virtualagc/agc_hardware/(threads)

Thread 1 (2021-01-28):

[question] INKBT1 dependency on STD2

emgre, 2021-01-28:
Hi, this more of a question than an issue.

I've been working on a control-pulse accurate emulator (available [here](https://github.com/emgre/agc)), and I ran into an issue when executing extended instructions. I couldn't understand the output of the Verilog simulation (generated from these schematics), where `INKBT1` was sometimes not high on `T01` even if `INKL` was always low (therefore not resetting the `NISQL` flip-flop).

`INKBT1` is defined in module A03, in the first sheet.

The schematics of ND-1021042 is the following:
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

Eldon C. Hall schematics also show the same thing:
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

However, in your KiCAD files here, you've added `STD2` to the gate:
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

Here's an example to show how `STD2` is important (notice how `NISQL` stays high when executing the extended instruction):
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

Your modification actually resolves my issue, so it's probably right. However, I wonder where you've picked this up? Are there more up-to-date schematics available somewhere, or you found that by simulation?

thewonderidiot, 2021-01-28:
Hey, that's awesome, I'll have to check it out!

STD2 gets added onto the INKBT1 net via a standalone gate in [module A21](http://klabs.org/history/ech/agc_schematics/logic/a21-2.jpg):
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

Given its location in the design, I'm guessing it was most likely a late addition to the logic that had to be added to a spare gate because the third input to gate 30061 wasn't routed out to a backplane pin.

Back when I made these schematics I was trying to go for a minimum-part replica, so I combined all of the fan-in expander gates with their parent gates wherever possible... thus its turning into a single 3-input gate in my schematics.

For instances like this, if you think there might be additional inputs to a net, it might help to use the [backplane viewer](http://apolloguidance.computer/2003993_061/pins) to search for them. If you click on the name of the "Net" on the right side toolbox, you can type in the name of a net ("INKBT1") in this case and hit enter, and it will highlight all connections to that net. That's how I dug up the above gate just now. :smile:

Hope this helps!

thewonderidiot, 2021-01-28:
I did a bit more reading and can confirm that gate 32257 in module A21 was allocated for this purpose between [revision D](https://archive.org/stream/apertureCardBox459NARASW_images/apertureCardBox459NARASW#page/n1709/mode/1up) and [revision E](https://archive.org/stream/apertureCardBox459NARASW_images/apertureCardBox459NARASW#page/n1712/mode/1up) of drawing 2005050, the schematic for the earlier nickel-ribbon version of module A21.

It's hard to read the dates, but it appears that revision E occurred in late August or September of 1965. The design release for Block II was in July of that year, so at that point it definitely would have been desirable to fix design issues with a couple of extra wires on the backplane rather than a respin of module A03, wherever possible.

emgre, 2021-01-28:
Thanks for your answer! That gate was well hidden 🥸 I wasn't aware of that backplane viewer, that's awesome!

I'm using your Verilog simulation to output a CSV of all the register values at each timepulse, then I run my Rust emulator and check that every register agrees with the CSV values. I can execute the first 100 subinstructions of Aurora12 like that. Here's the test code: https://github.com/emgre/agc/blob/master/agc/tests/conformance.rs

Closed 2021-01-28.
