virtualagc/agc_hardware/dsky/indicator_driver/indicator_driver.kicad_pcb

## KiCad design dsky/indicator_driver/indicator_driver.kicad_pcb (2017-06-05)

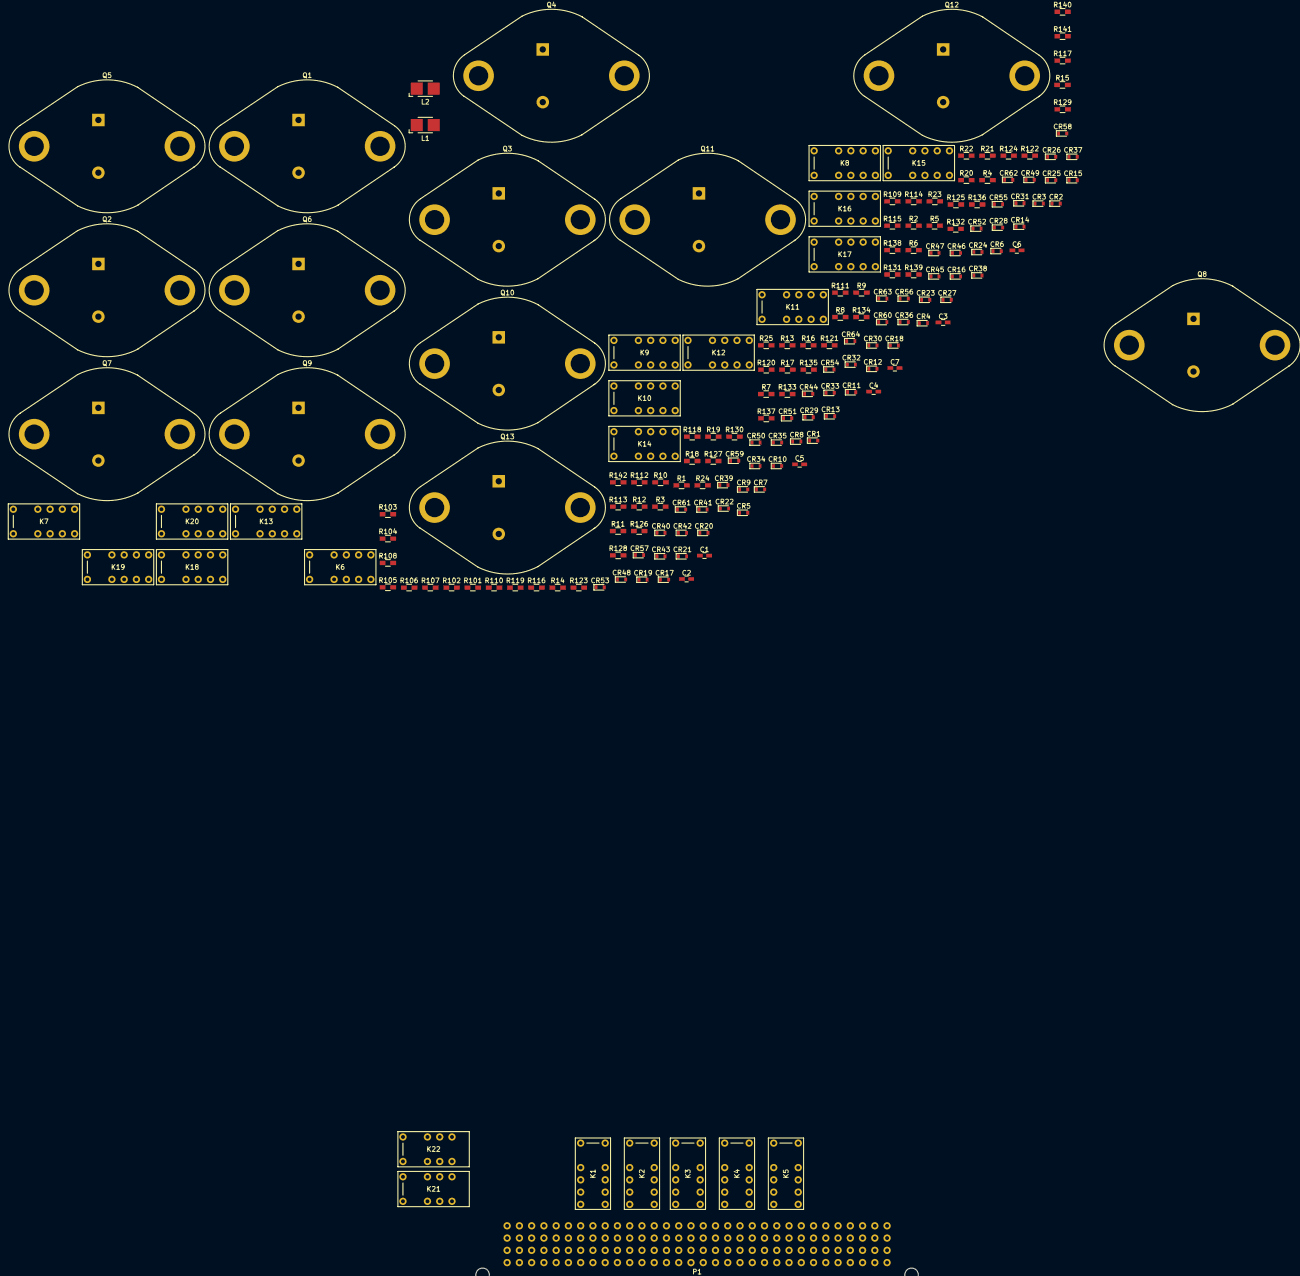
[picture p1: board indicator_driver.kicad_pcb from above]

Board: 2 copper layers, 176 parts (0 on the bottom side), 221 nets, no tracks yet.

Parts:
C1, C2: 4.7uF; C_0603_HandSoldering
C3, C4, C5, C6, C7: 0.1uF; C_0603_HandSoldering
CR1, CR2, CR3, CR4, CR5, CR6, CR7, CR8, CR9, CR10, CR11, CR12, CR13, CR14, CR15, CR16, CR17, CR18, CR19, CR20, CR21, CR22, CR23, CR24, CR25, CR26, CR27, CR28, CR29, CR30, CR31, CR32, CR33, CR34, CR35, CR36, CR37, CR38, CR39, CR40, CR41, CR42, CR43, CR44, CR45, CR46, CR47, CR48, CR49, CR50, CR51, CR52, CR53, CR54, CR55, CR56, CR57, CR58, CR59, CR60, CR61, CR62, CR63, CR64: D; D_0603
K1, K2, K3, K4, K5, K6, K7, K8, K9, K10, K11, K12, K13, K14, K15, K16, K17, K18, K19, K20: EC2-12TNU
K21, K22: EC2-12NU
L1, L2: 8.2uH; Inductor_1212
P1: PCN10A-128P
Q1, Q8, Q9, Q10, Q11, Q12, Q13: PN2907A; TO-3
Q2, Q3, Q4, Q5, Q6, Q7: PN2222A; TO-3
R1, R2, R3, R4, R6, R7, R9, R11, R12, R15, R16, R19, R22, R24: 10k; R_0603_HandSoldering
R5, R8, R10: 18k; R_0603_HandSoldering
R13, R17: 20k; R_0603_HandSoldering
R14, R18, R21, R23: 2k; R_0603_HandSoldering
R20, R25: 1k; R_0603_HandSoldering
R101, R102, R103, R104, R105, R106, R107, R108, R109, R110, R111, R112, R113, R114, R115, R116, R117, R118, R119, R120, R121, R122, R123, R124, R125, R126, R127, R128, R129, R130, R131, R132, R133, R134, R135, R136, R137, R138, R139, R140, R141, R142: 1.5k; R_0603_HandSoldering

Connections:
+28VDC: L1.1, P1.112
GND: C1.2, C2.2, CR47.2, CR48.2, CR49.2, CR50.2, P1.68, P1.105, Q2.1, Q3.1, Q5.1, Q7.1, R4.2, R7.2, R9.2, R11.2, R20.2, R25.2
unnamed: C1.1, L1.2, L2.1
unnamed: C2.1, C3.1, C4.1, C5.1, C6.1, C7.1, CR43.1, CR45.1, L2.2, Q1.1, Q8.1, Q9.1, Q10.1, Q11.1, Q12.1, Q13.1, R2.1, R3.1, R14.1, R15.1, R18.1, R19.1, R21.1, R23.1
unnamed: C3.2, Q1.2, R1.1, R2.2
unnamed: C4.2, Q8.2, R12.1, R14.2
unnamed: C5.2, Q10.2, R16.1, R18.2
unnamed: C6.2, Q12.2, R21.2, R22.1
unnamed: C7.2, Q13.2, R23.2, R24.1
unnamed: CR1.2, K1.12
unnamed: CR2.2, K1.7
unnamed: CR3.2, K2.12
unnamed: CR4.2, K2.7
unnamed: CR5.2, K3.12
unnamed: CR6.2, K3.7
unnamed: CR7.2, K4.12
unnamed: CR8.2, K4.7
unnamed: CR9.2, K5.12
unnamed: CR10.2, K5.7
unnamed: CR11.2, K6.12
unnamed: CR12.2, K6.7
unnamed: CR13.2, K7.12
unnamed: CR14.2, K7.7
unnamed: CR15.2, K8.12
unnamed: CR16.2, K8.7
unnamed: CR17.2, K9.12
unnamed: CR18.2, K9.7
unnamed: CR19.2, K10.12
unnamed: CR20.2, K10.7
unnamed: CR21.2, K11.12
unnamed: CR22.2, K11.7
unnamed: CR23.2, K12.12
unnamed: CR24.2, K12.7
unnamed: CR25.2, K13.12
unnamed: CR26.2, K13.7
unnamed: CR27.2, K14.12
unnamed: CR28.2, K14.7
unnamed: CR29.2, K15.12
unnamed: CR30.2, K15.7
unnamed: CR31.2, K16.12
unnamed: CR32.2, K16.7
unnamed: CR33.2, K17.12
unnamed: CR34.2, K17.7
unnamed: CR35.2, K18.12
unnamed: CR36.2, K18.7
unnamed: CR37.2, K19.12
unnamed: CR38.2, K19.7
unnamed: CR39.2, K20.12
unnamed: CR40.2, K20.7
unnamed: CR44.1, Q4.2, R9.1
unnamed: CR46.1, Q6.2, R11.1
unnamed: CR59.1, CR60.1, CR61.1, CR62.1, CR63.1, CR64.1, Q3.3
unnamed: K1.1, R101.1
unnamed: K1.6, R102.2
unnamed: K2.1, R103.1
unnamed: K2.6, R104.2
unnamed: K3.1, R105.1
unnamed: K3.4, K5.3
unnamed: K3.6, R106.2
unnamed: K4.1, R107.1
unnamed: K4.6, R108.2
unnamed: K5.1, R109.1
unnamed: K5.6, R110.2
unnamed: K6.1, R111.1
unnamed: K6.6, R112.2
unnamed: K7.1, R113.1
unnamed: K7.6, R114.2
unnamed: K8.1, R115.1
unnamed: K8.6, R116.2
unnamed: K9.1, R117.1
unnamed: K9.6, R118.2
unnamed: K10.1, R119.1
unnamed: K8.4, K10.3
unnamed: K10.6, R120.2
unnamed: K11.1, R121.1
unnamed: K11.6, R122.2
unnamed: K12.1, R123.1
unnamed: K12.6, R124.2
unnamed: K13.1, R125.1
unnamed: K13.4, K15.3
unnamed: K13.6, R126.2
unnamed: K14.1, R127.1
unnamed: K14.6, R128.2
unnamed: K15.1, R129.1
unnamed: K15.6, R130.2
unnamed: K16.1, R131.1
unnamed: K16.6, R132.2
unnamed: K17.1, R133.1
unnamed: K17.6, R134.2
unnamed: K18.1, R135.1
unnamed: K18.6, R136.2
unnamed: K19.1, R137.1
unnamed: K19.6, R138.2
unnamed: K20.1, R139.1
unnamed: K20.6, R140.2
unnamed: K21.12, R141.2
unnamed: K22.12, R142.2
unnamed: Q3.2, R6.1, R7.1
unnamed: Q4.1, Q5.2, R25.1
unnamed: Q6.1, Q7.2, R20.1
unnamed: Q9.2, R13.1, R15.2
unnamed: Q11.2, R17.1, R19.2
P1: K21.5, P1.1
P2: K21.10, P1.2
P3: K22.5, P1.3
P4: CR42.1, K22.1, P1.4
P5: K22.3, P1.5
P6: K22.4, P1.6
P7: CR41.1, K21.1, P1.7
P8: K21.9, P1.8
P9: K16.10, K17.10, P1.9
P10: K21.8, P1.10
P11: K21.4, P1.11
P12: K21.3, P1.12
P13: K11.10, K12.10, K13.3, K13.10, K14.10, K15.10, K19.10, K20.3, K20.10, P1.13
P14: P1.14, R102.1, R112.1, R122.1
P15: K16.5, P1.15
P16: K1.10, K2.10, K3.3, K3.10, K4.10, K5.10, K6.10, K7.10, K8.3, K8.10, K9.10, K10.10, P1.16
P17: K11.9, P1.17
P18: K16.9, P1.18
P19: P1.19, R132.1
P20: K16.3, P1.20
P21: K16.4, P1.21
P22: K1.9, P1.22
P23: P1.23, R101.2, R111.2, R121.2
P24: K6.9, P1.24
P25: K17.5, P1.25
P26: CR41.2, CR42.2, P1.26, R141.1, R142.1
P27: K16.8, P1.27
P28: P1.28, R131.2
P29: K12.5, K15.9, P1.29
P30: K2.5, K5.9, P1.30
P31: K17.3, P1.31
P32: K1.8, K2.3, K3.8, K4.8, K5.5, K5.8, K6.8, K7.3, K8.8, K9.8, K10.5, K10.8, K11.8, K12.3, K13.8, K14.8, K15.5, K15.8, K19.5, K19.8, K20.8, P1.32
P33: P1.33, R134.1
P34: K12.9, P1.34
P35: P1.35, R104.1, R114.1, R124.1
P36: K7.5, K10.9, P1.36
P37: K17.4, P1.37
P38: K17.9, P1.38
P39: K2.9, P1.39
P40: K7.9, P1.40
P41: K2.4, P1.41
P42: K7.4, P1.42
P43: K12.4, P1.43
P44: P1.44, R103.2, R113.2, R123.2
P45: K18.3, P1.45
P46: K18.5, P1.46
P47: CR31.1, CR32.1, CR33.1, CR34.1, CR35.1, CR36.1, P1.47
P48: P1.48, R133.2
P49: K8.5, K9.9, P1.49
P50: K13.5, K14.9, P1.50
P51: P1.51, R106.1, R116.1, R126.1
P52: P1.52, R136.1
P53: K12.8, K13.9, P1.53
P54: K7.8, K8.9, P1.54
P55: K2.8, K3.9, P1.55
P56: K3.5, K4.9, P1.56
P57: K17.8, K18.8, P1.57
P58: K18.4, P1.58
P59: P1.59, R135.2
P60: K18.9, P1.60
P61: P1.61, R108.1, R118.1, R128.1
P62: P1.62, R105.2, R115.2, R125.2
P63: K19.3, P1.63
P64: K18.10, P1.64
P65: P1.65, R107.2, R117.2, R127.2
P66: CR11.1, CR12.1, CR13.1, CR14.1, CR15.1, CR16.1, CR17.1, CR18.1, CR19.1, CR20.1, P1.66
P67: CR21.1, CR22.1, CR23.1, CR24.1, CR25.1, CR26.1, CR27.1, CR28.1, CR29.1, CR30.1, P1.67
P69: CR37.1, CR38.1, P1.69
P70: K19.9, P1.70
P71: CR1.1, CR2.1, CR3.1, CR4.1, CR5.1, CR6.1, CR7.1, CR8.1, CR9.1, CR10.1, P1.71
P72: P1.72, R138.1
P73: P1.73, R110.1, R120.1, R130.1
P74: K20.5, P1.74
P75: P1.75, R137.2
P76: K19.4, P1.76
P77: P1.77, R109.2, R119.2, R129.2
P78: K15.4, P1.78
P79: K20.9, P1.79
P80: P1.80, R140.1
P81: P1.81, R139.2
P82: K20.4, P1.82
P83: K5.4, P1.83
P84: K10.4, P1.84
P85: P1.85, R22.2
P86: P1.86, R24.2
P87: P1.87, Q12.3
P88: CR39.1, CR40.1, P1.88
P89: P1.89, R16.2
P90: P1.90, R12.2
P91: P1.91, R1.2
P92: P1.92, Q1.3
P94: CR57.2, P1.94
P95: P1.95, Q13.3
P97: CR53.2, P1.97
P98: CR54.2, P1.98
P99: CR55.2, P1.99
P100: CR56.2, P1.100
P101: CR49.1, P1.101, Q11.3
P102: CR47.1, P1.102, Q9.3
P103: CR50.1, P1.103, Q10.3, R17.2
P104: CR48.1, P1.104, Q8.3, R13.2
P106: CR46.2, P1.106, R10.2
P107: CR44.2, R8.2
P108: CR52.2, P1.108
P109: CR60.2, P1.109
P110: CR51.2, P1.110
P111: CR51.1, CR52.1, CR53.1, CR54.1, CR55.1, CR56.1, CR57.1, P1.111, Q2.3, R3.2, R6.2
P113: CR45.2, P1.113, Q6.3, Q7.3
P114: CR43.2, P1.114, Q4.3, Q5.3
P115: P1.115, R5.2
P116: CR59.2, P1.116
P117: CR62.2, P1.117
P118: CR61.2, P1.118
P119: P1.119, Q2.2, R4.1, R5.1
P120: P1.120, R8.1, R10.1
P121: CR58.1, P1.121
P122: CR64.2, P1.122
P123: CR58.2, P1.123
P124: CR63.2, P1.124
