virtualagc/agc_hardware/(commit log)

2015-10-11 Initial schematicery
    [timer.kicad_pcb, timer.sch]
2015-10-11 More of page 1 of the timer module (poorly drawn)
    [timer.sch]
2015-10-13 Fleshed out the rest of page 1 of the timer module
    [timer.sch]
2015-10-13 Added PHS3/ from A24-2 since it makes more sense in the timer modules, along with the two monitor signals on A2-1, and an inverter and signal I missed
    [timer.sch]
2015-10-18 Pushed page A02-1 down into a heirarchical sheet, while retaining the P1 connector at the top level. Also added the beginnings of page A02-2. The four-phase clock divider is now also on its own page,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
    [a02_1.sch, a02_2.sch, clock_divider.sch, timer.sch]
2015-10-20 Added the start/stop logic to timer page A02-2, and introduced a new part, 74LVC07, that I think will be the solution for open drain things
    [a02_2.sch, clock_divider.sch, timer.sch]
2015-10-24 Added the final page of the timer module. Leaving top-level wiring pretty bare for now until I have a better idea of what's needed outside the module.
    [a02_1.sch, a02_2.sch, a02_3.sch, clock_divider.sch, timer.sch]
2015-10-24 Added the entire scaler module! Didn't flesh out the I/O much, I'll do that as needed. Also, the clock divider's labeling here is different from the one in the timer module, which is consistent with 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
    [a01_1.sch, a01_2.sch, clock_divider.sch, scaler.kicad_pcb, scaler.sch, timer.sch]
2015-10-25 Beginnings of the SQ Register and Decoding module -- mostly SQ read/write/clear logic
    [a03_1.sch, sq_register.kicad_pcb, sq_register.sch]
2015-10-26 Filled out the rest of page A03-1. At the very least, it appears to be properly handling the GOJAM condition. Haven't looked much at non-GOJAM behavior. I also exposed T01..T12 and T01/..T12/ as outp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
    [a02_2.sch, a03_1.sch, sq_register.sch, timer.sch]
2015-10-27 Renamed components in the timer module to fit the new numbering scheme (module_number * 1000 + part number), and updated initial conditions to make simulation happy again after fixes
    [a02_1.sch, a02_2.sch, a02_3.sch, a03_1.sch, clock_divider.sch]
2015-10-29 Finished off the SQ Register and Decoder module. Next up is the stage and branch registers
    [a03_1.sch, a03_2.sch, sq_register.sch]
2015-10-29 Added the 'stage' bit of the Stage Branch Decoder module, and cleaned up a lot of initial conditions (still probably a lot to be done there)
    [a02_1.sch, a02_2.sch, a02_3.sch, a03_1.sch, a03_2.sch, a04_1.sch, sq_register.sch, stage_branch.kicad_pcb]
2015-10-29 More initial conditions fixes, prevents STG3 from oscillating and freqking out TC0
    [a03_1.sch, a03_2.sch, a04_1.sch]
2015-10-31 Finished off the first page of the Stage Branch Decoding module.
    [a04_1.sch, sq_register.sch, stage_branch.sch, timer.sch]
2015-11-01 Added the strobe pulses to the timer
    [a02_2.sch, clock_divider.sch, timer.sch]
2015-11-20 Added a library part for a 128-pin DIN 41612 connector. It's unclear if 128 pins will be enough for some modules (yikes) but I'm going to try my hardest to make it work.
2015-11-20 Added page 2 of the Stage Branch Decoding module, and tied it into the rest of the system
    [a03_1.sch, a03_2.sch, a04_1.sch, a04_2.sch, sq_register.sch, stage_branch.sch]
2015-11-26 Added the first page of the Crosspoint Generator NQI module. Not dealing with I/O until page 2 is also present...
    [a05_1.sch, crosspoint_nqi.kicad_pcb, crosspoint_nqi.sch]
2015-12-19 Finished the second page of crosspoint generator 1 and tied it into the rest of the system.
    Turns out most documentation online is wrong, and block 2 modules have 276 pins per module to the backplane, rather than the 140-144 that is quoted everywhere (those are block 1 figures). Instead of dealing with connector selection again, I opted to just add another row to the '128-pin' connector. I'll fix that more properly later
    [a03_1.sch, a03_2.sch, a05_1.sch, a05_2.sch, crosspoint_nqi.sch, sq_register.sch, stage_branch.sch]
2015-12-20 First page of module A06, crosspoint generator #2.
    There's a lot of gates I left out that produce unused (monitor?)
    signals... namely the S01..S07/ -> IL01..IL07/ mappings, and the
    RSTK/ -> RSTKX/ + RSTKY/ things. I also moved what looks like additional
    timer logic to page 2 of the timer module (it's a really good fit there
    because no new input pins are needed, all involved signals are generated
    on that page).
    [a02_2.sch, a06_1.sch, crosspoint_ii.kicad_pcb, crosspoint_ii.sch, timer.sch]
2015-12-22 Page 2 of module 6, plus a few corrections.
    Changed RPTSET in module 3 from an output to an input. Dropped unneeded
    pullups from R1C/ (turns out this missing one is in module 6) and RB1/
    (I don't remember why that was there) in module 4.
    [a03_1.sch, a04_2.sch, a06_1.sch, a06_2.sch, crosspoint_ii.sch, sq_register.sch]
2015-12-23 Tied in module 6 and corrected a handful of naming/routing errors... most notably some missing gates from A06-1
    [a04_1.sch, a04_2.sch, a05_1.sch, a05_2.sch, a06_1.sch, a06_2.sch, crosspoint_ii.sch, sq_register.sch]
2015-12-24 A few crosspoint touchups I missed
    [crosspoint_nqi.sch]
2015-12-24 Page 1 of module 7, the service gates
    [a07_1.sch, service_gates.kicad_pcb, service_gates.sch]
2015-12-29 Page 2 of the service gates, including some service logic taken from modules 14 and 24 (page 1 got some updates too)
    [a07_1.sch, a07_2.sch, service_gates.sch]
2015-12-29 Broke out some open drain signals that were only partially onto the backplane... I missed them because inouts are sufficient to satisfy an input criterion, so there's no error if only part of the sig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
    [crosspoint_ii.sch, crosspoint_nqi.sch]
2015-12-30 Tied in module 7, and corrected lots of errors.
    Off the top of my head:
    * T12DC/ not actually connected to restart logic in A02-2
    * IC12/ and IC13 schematic errors
    * Lots of gates moved from later modules up to modules 2-7
    * YT0..7 logic dropped from 7, it belongs in 14
    * Lots of missing signal breakouts
    * ...probably some other things, I should keep a list as I go
    All control pulses associated with GOJ1 now behave correctly during
    GOJ1.
    [a02_2.sch, a02_3.sch, a03_1.sch, a03_2.sch, a04_1.sch, a04_2.sch, a05_1.sch, a05_2.sch]
2016-01-03 More corrections, TC0, CA0, and STD2 all have the right pulses now
    [a06_2.sch, crosspoint_nqi.sch]
2016-01-03 Added a generic two-bit-column sheet that I'm going to try to handle with symlinks, plus a basic module 8 to contain the first instance of it
    [four_bit_1.kicad_pcb, four_bit_1.sch, two_bit_columns.sch]
2016-01-03 Added the second instance of the two-bit-columns sheet. Wiring of module 8 next
    [four_bit_1.sch, two_bit_columns.sch]
2016-01-05 Tied in module 8, and corrected lots of initial conditions.
    The registers and ALU appear to work now, with TC0 and STD2 shuffling things around correctly, and Z counting up as instructions execute.
    [a02_3.sch, a03_2.sch, a04_2.sch, a05_1.sch, a05_2.sch, a06_1.sch, a06_2.sch, a07_1.sch]
2016-01-06 Fully added / tied in module 9. Yay for identical logic!
    [four_bit_2.kicad_pcb, four_bit_2.sch, two_bit_columns.sch]
2016-01-06 Added a fully tied in module 10.
    [four_bit_2.sch, four_bit_3.kicad_pcb, four_bit_3.sch, service_gates.sch, two_bit_columns.sch]
2016-01-31 Added the final four bit module. All 16 bits of the central/special registers are present. We're stuck at address 0 because TC is using RAD, which needs to be translated into RG or RZ by module 12
    [a03_1.sch, a03_2.sch, a06_1.sch, a07_1.sch, a07_2.sch, crosspoint_ii.sch, four_bit_3.sch, four_bit_4.kicad_pcb]
2016-01-31 Added in WHOMP, whatever it is
    [a06_1.sch, crosspoint_ii.sch, four_bit_1.sch, four_bit_2.sch, four_bit_3.sch, four_bit_4.sch, two_bit_columns.sch]
2016-02-07 Added and tied in module 12, parity & s register
    [a02_3.sch, a05_2.sch, a06_1.sch, a06_2.sch, a07_1.sch, a07_2.sch, a12_1.sch, a12_2.sch]
2016-02-11 Bux fixes for things found during FPGA integration.
    * A05 was driving TSGN/ directly instead of with an OD buffer+pullup
    * Some bad logic with crosspoints in module 5
    * A bad part number in module 12
    * Removal of unused signals from the backplane connectors
    * Addition of some monitor signals from the timer to the backplane
    [a05_1.sch, a05_2.sch, a12_1.sch, crosspoint_nqi.sch, stage_branch.sch, timer.sch]
2016-02-12 Fixed oscillations of OVFSTB/ in the timer module
    [a02_1.sch, a02_2.sch, a02_3.sch, timer.sch]
2016-02-13 First bit of memory timing and addressing (fixed memory timing)
    [a14_1.sch, memory_timing_addressing.kicad_pcb, memory_timing_addressing.sch]
2016-02-17 Corrected a couple of bugs found by Quartus (L16/, Z15/, Z16/ not connected)
    [crosspoint_nqi.sch, four_bit_4.sch, stage_branch.sch]
2016-02-19 Finished off and integrated module 14. Also fixed a couple of bugs this turned up (both initial conditions, and bad wiring in the CGMC pulse generator and S register)
    [a04_2.sch, a05_2.sch, a06_1.sch, a06_2.sch, a07_1.sch, a12_2.sch, a14_1.sch, a14_2.sch]
2016-02-21 Added and tied in module 15, the rupt service (and banking/rope+strand selection)
    [a06_2.sch, a07_2.sch, a15_1.sch, a15_2.sch, crosspoint_ii.sch, crosspoint_nqi.sch, four_bit_1.sch, four_bit_2.sch]
2016-02-24 New module: custom memory! This uses a flash chip and decodes address based entirely off of rope control signals.
    [a14_1.sch, b01_1.sch, fixed_erasable_memory.kicad_pcb, fixed_erasable_memory.sch, memory_timing_addressing.sch, rupt_service.sch]
2016-02-28 Updated fixed memory model, plus various bugfixes
    Rope memory control signals are now decoded much earlier in the cycle to
    determine the target address, allowing slower memory devices (such as
    the EPCS on the DE0 Nano) enough time to load their data.
    The bugfixes are mostly wiring errors discovered by debugging lockups in
    when running Colossus 237 -- all were causing the ST2 pulse to not
    occur, so errors that *don't* prevent ST2 from happening very well might
    be present in the instructions that have been fixed.
    The computer now gets through the initialization code and enters an
    infinite loop when attempting to invoke the interpeter, due to the lack
    of erasable memory.
    [a03_2.sch, a04_2.sch, a05_1.sch, b01_1.sch, fixed_erasable_memory.sch, memory_timing_addressing.sch, rupt_service.sch]
2016-03-04 Added erasable memory, and fixed lots of random wiring errors.
    I decided to go with a 16-bit-wide MRAM chip -- I had no idea
    until I started researching RAM options how technologically
    similar MRAM is to core memory. The datasheet diagrams look like
    they're straight out of the AGC documentation!
    There's a slight inaccuracy in this implementation worth mentioning.
    Like fixed memory, I've wired the sense amplifier outputs directly up
    to the tristate data output pins of the MRAM chip. But because the
    data lines are bidirectional, data being written into RAM will show up
    on the sense lines, and go straight into the ungated G register. Since
    G is what's being written out, this doesn't matter 99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
    [a04_1.sch, a04_2.sch, a05_1.sch, a05_2.sch, a06_1.sch, a07_2.sch, a12_1.sch, a12_2.sch]
2016-03-06 Higher fidelity rope logic that doesn't break with DV.
    Divide, somewhat strangely, handles the ropes differently during its
    execution than any other instruction (at least, that I've seen). It does
    full cycles on a rope, just without strobing the sense amplifiers at the
    end. Plus, that rope is kinda random -- DV1 timepulse 8 seems to set bit
    12 of S for some reason. Anyways, I had to switch to three edge
    detectors that clear the A/B/C quarter latches with the RESETA, RESETB,
    and RESETC pulses, instead of just using SBF for everything.
    [b01_1.sch]
2016-03-06 New bidirectional codegen flags for the MRAM chip.
    [b01_2.sch]
2016-03-13 Added counter cell 1. No output pins to the backplane yet
    [a20_both.sch, counter_cell_i.kicad_pcb, counter_cell_i.sch]
2016-03-26 Added in counter cell 2.
    I moved some logic from module 5 that's related to counters into page 1,
    and completely moved page 2 out, since it has more to do with monitor
    stuff. That'll show up as page 2 of module 13.
    [a05_1.sch, a05_2.sch, a21_1.sch, a21_3.sch, counter_cell_ii.kicad_pcb, counter_cell_ii.sch, crosspoint_nqi.sch]
2016-03-26 Tied in modules 20 and 21
    [a21_1.sch, a21_3.sch, counter_cell_i.sch, counter_cell_ii.sch, crosspoint_nqi.sch, memory_timing_addressing.sch]
2016-04-01 Added and tied in the Alarms module.
    I've placed page 2 of Counter Cell 2 here as page 2 of alarms. It didn't
    fit in the counter cells, despite producing a few counter-related
    signals -- and it mostly handles monitor stuff, which is a good fit for
    what's going on here. As part of this I modernized the timer and scaler
    connectors.
    There seems to be lots of oscillations in the the simulation. Initial
    conditions to correct those to follow.
    [a01_1.sch, a02_2.sch, a02_3.sch, a13_1.sch, a13_2.sch, a21_1.sch, alarms.kicad_pcb, alarms.sch]
2016-04-02 Initial conditions for the counter cells
    [a20_both.sch, a21_3.sch]
2016-04-09 Inout IV. Not yet tied into the backplane.
    [a19_1.sch, a19_2.sch, inout_iv.kicad_pcb, inout_iv.sch]
2016-04-09 Tied in Inout IV and renamed MONPCH to the original MON+CH
    [a01_1.sch, a02_2.sch, a05_1.sch, a05_2.sch, a06_2.sch, a13_2.sch, a19_1.sch, a19_2.sch]
2016-04-09 Corrected some bad identifiers found by Quartus
    [a20_both.sch, b01_2.sch]
2016-04-10 Inout II. Not yet tied in.
    [a17_1.sch, a17_2.sch, inout_ii.kicad_pcb, inout_ii.sch]
2016-04-10 Tied in Inout II.
    [a01_1.sch, a17_1.sch, a17_2.sch, alarms.sch, inout_ii.sch, inout_iv.sch, scaler.sch, service_gates.sch]
2016-04-12 Added and tied in Inout I
    [a16_1.sch, a16_2.sch, inout_i.kicad_pcb, inout_i.sch, inout_ii.sch]
2016-04-14 First half-ish of Inout III
    [a18_1.sch, a18_2.sch, inout_iii.kicad_pcb, inout_iii.sch]
2016-04-16 Added most of the rest of Inout III and tied it in. Still not sure where to put the downlink stuff, standby, and CHOR propers.
    [a01_1.sch, a18_1.sch, a18_2.sch, inout_iii.sch, inout_iv.sch, scaler.sch, timer.sch]
2016-04-17 Added and tied in Inout V.
    [a22_1.sch, a22_2.sch, inout_v.kicad_pcb, inout_v.sch, parity_s_register.sch, rupt_service.sch]
2016-04-18 Added and tied in Inout VI. Pulled in all PIPA related things. Almost there!
    [a07_1.sch, a19_2.sch, a22_2.sch, a23_1.sch, a23_2.sch, inout_i.sch, inout_ii.sch, inout_iv.sch]
2016-04-20 Added interrupt inhibition to module 3
    [a03_1.sch, crosspoint_nqi.sch, four_bit_4.sch, sq_register.sch, two_bit_columns.sch]
2016-04-20 Fixed the two bit column simlink in four bit 4
    [two_bit_columns.sch]
2016-04-21 Added and tied in Inout VII, the final logic module!
    I still need to comb through the schematics to see if there are any
    stray gates I missed. The initial conditions are also pretty much
    guaranteed to be wrong. But it's mostly all there!
    [a04_2.sch, a06_1.sch, a24_1.sch, a24_2.sch, four_bit_1.sch, four_bit_2.sch, four_bit_3.sch, four_bit_4.sch]
2016-04-21 Corrected a couple of wiring errors in the scaler
    [a01_1.sch, a01_2.sch]
2016-04-22 Lots of initial conditions, some missed gates, and some wiring fixes
    [a03_1.sch, a06_1.sch, a07_1.sch, a13_1.sch, a14_1.sch, a16_1.sch, a18_1.sch, a18_2.sch]
2016-04-28 Did another pass through the schematics and added in some missing gates
    [a03_2.sch, a13_1.sch, a15_2.sch, a18_1.sch, alarms.sch, inout_iii.sch, sq_register.sch]
2016-04-30 Corrected some bad part identifiers
    [a03_1.sch, a23_1.sch, a24_1.sch]
2016-04-30 Broke out most (all?) of the DSKY outputs
    [a16_2.sch, alarms.sch, inout_i.sch, inout_ii.sch]
2016-05-05 Pulled out RESTRT and SBYLIT for the final two DSKY lights
    [alarms.sch, inout_iii.sch]
2016-05-05 Corrected RESTART light polarity in the alarms module
    [a13_1.sch]
2016-06-23 Added basic DSKY relay decoding and a library part for the relays
    [indicator_driver.kicad_pcb, indicator_driver.sch, seven_segment_decoder.sch]
2016-07-23 Added some missing net names.
    [a04_1.sch, a24_2.sch]
2016-07-24 Broke out some PIPA and CDU-related output signals, and fixed the polarity of PIPPLS/
    [a23_2.sch, a24_1.sch, a24_2.sch, inout_vi.sch, inout_vii.sch]
2016-09-14 Broke all the monitor outputs I could find out to the backplane, in preparation for making a monitor
    [a03_1.sch, a03_2.sch, a04_1.sch, a04_2.sch, a06_1.sch, a12_1.sch, alarms.sch, crosspoint_ii.sch]
2016-09-18 Corrected a wiring error in the Monitor request logic (ST1 in place of ST0) and an initial condition problem in the scaler causing the computer to come up with night watchman alarm
    [a13_1.sch, a13_2.sch, alarms.sch, clock_divider.sch]
2016-10-01 Made erasable memory reads destructive, and improved erasable address latching logic
    [b01_2.sch, fixed_erasable_memory.sch, memory_timing_addressing.sch]
2016-10-04 Some initial condition updates to fix a couple oscillating signals I found
    [a13_1.sch, a23_1.sch]
2016-10-05 Fixed memory: inhibit reads if no rope is selected, which can happen when addressing non-present memory
    [b01_1.sch]
2016-10-06 SUPER BROKEN: Pulled in all NOR gates into the custom library, and changed the shape of 74HC04. Some, but not all, gates have standalone power pin parts. Scaler and Timer have been updated to use the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
    [a01_1.sch, a01_2.sch, a02_1.sch, a02_2.sch, a02_3.sch, clock_divider.sch, scaler.sch, timer.sch]
2016-10-08 Not gate rewiring up through module 11, with other cleanup here and there
    [a03_1.sch, a03_2.sch, a04_1.sch, a04_2.sch, a05_1.sch, a05_2.sch, a06_1.sch, a06_2.sch]
2016-10-09 Fixed not->1-input nor in the rest of the modules.
    [a12_1.sch, a12_2.sch, a13_1.sch, a13_2.sch, a14_1.sch, a14_2.sch, a15_1.sch, a15_2.sch]
2016-10-15 Added power pin units to most parts, +4VDC and +4VSW power components, and updated Scaler to use it all.
    [a01_1.sch, a01_2.sch, clock_divider.sch, scaler.sch]
2016-10-23 Added switched and unswitched power nets to the Timer. Also fixed a few glitches in the new library parts.
    [a02_1.sch, a02_2.sch, a02_3.sch, clock_divider.sch, timer.sch]
2016-10-23 Switched SQ Register & Decoder over to +4VSW and fixed some straggling VCCs in Timer
    [a02_2.sch, a02_3.sch, a03_1.sch, a03_2.sch, sq_register.sch, timer.sch]
2016-10-23 Updated Stage Branch Decoding to be on +4VSW
    [a04_1.sch, a04_2.sch, stage_branch.sch]
2016-10-23 Updated Crosspoint NQI to be on +4VSW
    [a05_1.sch, a05_2.sch, crosspoint_nqi.sch]
2016-10-23 Updated Crosspoint II to be on +4VSW
    [a06_1.sch, a06_2.sch, crosspoint_ii.sch]
2016-10-24 Updated Service Gates to be on +4VSW
    [a07_1.sch, a07_2.sch, service_gates.sch]
2016-10-24 Updated Four Bit 1 to be on +4VSW. Also compacted chip usage somewhat.
    [four_bit_1.sch, two_bit_columns.sch]
2016-10-24 Updated Four Bit 2 to be on +4VSW. Performed the same consolidation as in 1.
    [four_bit_2.sch, two_bit_columns.sch]
2016-10-26 Updated Four Bit 3 to be on +4VSW. Performed the same consolidation as in 1+2.
    [four_bit_3.sch, two_bit_columns.sch]
2016-10-26 Updated Four Bit 4 to be on +4VSW. Performed the same consolidation as in 1+2+3.
    [four_bit_4.sch, two_bit_columns.sch]
2016-10-26 Updated Parity and S Register to be on +4VSW
    [a12_1.sch, a12_2.sch, parity_s_register.sch]
2016-10-31 Set up Alarms for +4VDC and +4VSW power nets. Pretty sure I got all the standby stuff...
    [a13_1.sch, a13_2.sch, alarms.sch]
2016-10-31 Updated Memory Timing and Addressing to be on +4VSW
    [a14_1.sch, a14_2.sch, memory_timing_addressing.sch]
2016-11-01 Updated Rupt Service to be on +4VSW
    [a15_1.sch, a15_2.sch, rupt_service.sch]
2016-11-01 Updated Inout I to be on +4VSW
    [a16_1.sch, a16_2.sch, inout_i.sch]
2016-11-01 Updated Inout II to be on +4VSW
    [a17_1.sch, a17_2.sch, inout_ii.sch]
2016-11-01 Updated Inout III for the new power nets. Conveniently, only the standby-controlling stuff is on standby power
    [a18_1.sch, a18_2.sch, inout_iii.sch]
2016-11-01 Updated Inout IV to be on +4VSW
    [a19_1.sch, a19_2.sch, inout_iv.sch]
2016-11-02 Power net updates for Counter Cell I+II and Inout V
    [a20_both.sch, a21_1.sch, a21_3.sch, a22_1.sch, a22_2.sch, counter_cell_i.sch, counter_cell_ii.sch, inout_v.sch]
2016-11-02 Updated Inout VI to be on +4VSW
    [a23_1.sch, a23_2.sch, inout_vi.sch]
2016-11-02 Updated power nets for Inout VII. Almost there...
    [a24_1.sch, a24_2.sch, inout_vii.sch]
2016-11-02 Fixed/erasable memory on switched power, and voltage pin updates for the memories and tristate buffers
    [b01_1.sch, b01_2.sch, fixed_erasable_memory.sch]
2016-11-02 Pulled TIMR generation off of standby power, and consolidated some parts
    [a02_2.sch, a02_3.sch, a03_1.sch, a03_2.sch, a04_1.sch, a04_2.sch, a05_1.sch, a05_2.sch]
2016-11-02 Initial conditions for flash read logic
    [b01_1.sch]
2016-11-02 Some designator fixes for four bit 4, which apparently halfway thought it was module 10
    [four_bit_4.sch, two_bit_columns.sch]
2016-11-02 Broke out SBYREL/ for +4VSW switching
    [a18_1.sch, a18_2.sch, inout_iii.sch]
2016-11-05 New (original) seven-segment decoder, taken from the Apollo 12 Mission Report
    [indicator_driver.sch, seven_segment_decoder.sch]
2016-11-06 Added in the rest of the IDM hardware. Values and diode matrix design still need to be finalized. Working on wiring everything up now.
    [indicator_driver.sch, line_driver.sch, nonlatching_relay.sch, relay_driver.sch, seven_segment_decoder.sch]
2016-11-06 Finished initial wiring of the Indicator Driver Module. Currently sitting at 111 pins used, so I've been too aggressive at culling pins
    [indicator_driver.sch, line_driver.sch, seven_segment_decoder.sch]
2016-11-06 DSKY IDM: Cleaned up design rule errors. Still don't fully understand the common returh path.
    [indicator_driver.sch, line_driver.sch, nonlatching_relay.sch, relay_driver.sch, seven_segment_decoder.sch]
2016-11-06 Added a preliminary digital indicator board. Currently planning on custom 7SDs.
    [7SD.sch, digital_indicator.kicad_pcb, digital_indicator.sch, sign.sch]
2016-11-06 Basic alarm indicator module
    [alarm_indicator.kicad_pcb, alarm_indicator.sch]
2016-11-06 Added a DSKY keyboard board, which should be it for the DSKY outside of the backplane. Currently assuming I'll be making my own keys
    [keyboard.kicad_pcb, keyboard.sch]
2016-11-07 Upon re-reading R-700, the DSKY buttons were SPDT, not 1NO1NC. The keyboard has been updated accordingly.
    [keyboard.sch]
2016-11-07 The AGC only generates KEYRUPTs when it gets a non-zero keycode, so PRO can safely be on the keyboard reset chain.
    [keyboard.sch]
2016-11-07 The LM System Handbook, however, shows that PRO is *not* on the reset chain...
    Revert "The AGC only generates KEYRUPTs when it gets a non-zero keycode, so PRO can safely be on the keyboard reset chain."
    This reverts commit 773c8305ed61eff056e970f90c0f0f145b3fc18d.
    [keyboard.sch]
2016-11-07 Reordered all the keys in the DSKY keyboard to give them the same 'priority' as the original.
    [keyboard.sch]
2016-11-23 Fixed a label that became disconnected in module 6, causing DV to sometimes go off the rails
    [a06_1.sch, a06_2.sch, crosspoint_ii.sch]
2017-01-30 Added the CH77 alarm box (restart monitor) and switched most (all?) monitor outputs over to open drain, largely using new 74LVC06 parts (which are used *only* for monitor outputs)
    [a02_1.sch, a02_2.sch, a02_3.sch, a03_1.sch, a03_2.sch, a04_1.sch, a04_2.sch, a05_1.sch]
2017-03-25 Removed the '1' initial condition from the GOJ1 gate
    [a03_1.sch, a03_2.sch, sq_register.sch]
2017-03-26 Some initial condition updates for the CH77 alarm box and a monitor output I missed converting to 74LVC06
    [a04_1.sch, a04_2.sch, a12_1.sch, a12_2.sch, a13_1.sch, a13_2.sch, alarms.sch, ch77_alarm_box.sch]
2017-04-08 Preliminary LED layout for digital indicator board, plus connector and resistor network footprints
    [7SD.sch, digital_indicator.kicad_pcb, digital_indicator.sch, sign.sch]
2017-04-17 Rev. 1 of the Digital Indicator board
    [7SD.sch, digital_indicator.kicad_pcb, digital_indicator.sch, sign.sch]
2017-04-17 Revision 1 of the Alarm Indicator board
    [alarm_indicator.kicad_pcb, alarm_indicator.sch]
2017-05-15 Broke out the signals needed for downlink
    [a02_1.sch, a02_2.sch, a02_3.sch, a22_1.sch, a22_2.sch, clock_divider.sch, inout_v.sch, timer.sch]
2017-05-20 Digitized the real DSKY Indicator Driver Module schematic from ND-1021042
    [indicator_driver.sch]
2017-05-21 Redid the Keyboard Module according to ND-1021042 schematics. Also renumbered the DIN 41612 128P connector to make more DSKY sense
    [indicator_driver.sch, keyboard.sch]
2017-05-22 Added a footprint for the EC2-12TNU relay
2017-05-22 Added PCN10A-128P and EC2-12NU footprints
    [indicator_driver.kicad_pcb, indicator_driver.sch]
2017-06-05 Rewired the fixed/erasable memory such that bit 15 is now the parity bit (rather than bit 1)
    [b01_1.sch, b01_2.sch, fixed_erasable_memory.sch]
2017-06-09 Changed STRT2 to MYCLMP in module A14, per ND-1021042. Apparently there are *two* signals named STRT2 in the AGC, and the schematics don't differentiate them.
    [a14_1.sch, a14_2.sch, memory_timing_addressing.sch]
2017-06-24 First sheet of the DSKY backplane, plus the 6 IDM connectors.
    [backplane.kicad_pcb, backplane.sch, decoder_connections.sch, idm_connectors.sch]
2017-06-26 Digitized the Relay Matrix schematic diagram from ND-1021042 for the DSKY backplane
    [backplane.sch, decoder_connections.sch, idm_connectors.sch, relay_matrix.sch]
2017-07-10 Digitized the relay matrix signal flow schematic diagram for the DSKY backplane
    [backplane.sch, decoder_connections.sch, idm_connectors.sch, relay_matrix.sch, signal_flow.sch]
2018-10-20 Signal T05/ was inadvertantly being used in place of T06/ in one place in the schematics for AGC module A14. This doesn't seem to have affected the top-level behavior, but has nevertheless been fixed.
    [a14_1.sch, a14_2.sch, memory_timing_addressing.sch]
2018-10-29 This adds fixes to the schematics for changes identified in comparing against the independent AGC schematics in the "schematics" branch of the main Virtual AGC repository. Changes include: Topologica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
    [a02_1.sch, a02_2.sch, a02_3.sch, a07_1.sch, a07_2.sch, a12_1.sch, a12_2.sch, a14_1.sch]
